LihongYang99/clam_factory_deployment/Batch1-111626.xlsx

For company inventory for 11/16/2026----batch 1
 | Material list | Mode | Quantity needed | Unit Price | Total Price | Purchase Method | Note
Sensors | DO sensor | RS485 Fluorescence Dissolved Oxygen Sensor (Seawater) (https://www.dfrobot.com/product-3009.html) | 1 | 164.68 | 164.68 | P-card
 | ORP sensor | Industrial-Grade RS485 Water Quality ORP Sensor (https://www.dfrobot.com/product-3102.html) | 1 | 192.28 | 192.28 | P-card
 | Conductivity Sensor | Conductivity K 10 Kit (https://atlas-scientific.com/kits/conductivity-k-10-kit/) | 1 | 242.99 | 242.99 | P-card
 | Ammonia sensor | Industrial RS485 Water Quality Ammonia Nitrogen & pH Sensor | 1 | 0 | 0 | N/A(available in lab)
 | Underwater camera | Barlus Underwater Cameras 304 Stainless Steel IP68 5MP 2592×1944 POE IP Camera 32Ft Cable Koi Pond Camera | 1 | 205 | 205 | Hokiemart(464879)
IoT equipment | Router | MikroTik C53UiG+5HPaxD2HPaxD, IPQ-6010, 2.4/5 GHz, W127080453 (IPQ-6010, 2.4/5 GHz, 802.11a/n/ac/ax, 1200 Mbit/s, USB 3.0 Type A) | 1 | 165.99 | 165.99 | Hokiemart(464879)
 | ESP32 S3 Dev module(Pack of 3) | Hosyond 3Pack ESP32-S3 Development Board N16R8 MCU with Dual-Mode Wi-Fi Bluetooth Type-C, Compatible with Arduino IoT ESP32-S3-WROOM-1 | 2 | 18.05 | 36.1 | Hokiemart(464879)
 | RS485 to TTL | Waveshare Rail-Mount TTL to RS485 Isolated Converter, Multi-Isolation Protection, Compatible with TTL/RS485 Standard | 4 | 18.99 | 75.96 | 4 from Hokiemart(464879) | Already have 2 available in Lab
 | micro SD card | SANDISK 1TB Extreme microSD Card + Adapter, Up to 190MB/s Read Speeds | 1 | 234.88 | 234.88 | 5 from Hokiemart(464879)
 | Jetson Orin Nano Developer Kit | NVIDIA Jetson Orin Nano Super Developer Kit | 1 | 399 | 399 | Hokiemart(464879)
 | Electrically Isolated EZO™ Carrier Board | Electrically Isolated EZO™ Carrier Board | 2 | 0 | 0 | N/A(available in lab)
Accessory | DuPont Thread kit | 120pcs 50cm Breadboard Jumper Wires Assorted Kit,10cm 15cm 20cm 30cm 40cm 100cm Optional Dupont Wire 19.7 inch Male to Female Male to Male Female to Female Multicolored Ribbon Cable | 1 | 13.99 | 13.99 | Hokiemart(464879)
 | HDMI cable | N/A | 1 | 0 | 0 | N/A(available in lab)
 | PSU for ESP 32 | 10-Pack USB Wall Charger, 5V 2A UL Certified Power Adapter Block Bulk White | 1 | 21.99 | 21.99 | Hokiemart(464879) | have 3 available in lab
 | ESP 32 power cable | Android Auto USB Cable [3ft, 2-Pack] 10Gbps, 3A Fast Charging | 3 | 9.49 | 28.47 | Hokiemart(464879)
 | terminal block for ESP | 10PCS Lever Wire Connectors, 2 in 8 Out Quick Wire Connectors, Electrical Lever Nuts Wire Connectors Push-in Conductor Terminal Block AWG 28-12 | 1 | 11.39 | 11.39
 | PSU for DO and OPR sensors(12V) | ALITOVE DC 12V 5A Power Supply Adapter Converter Transformer 60W AC 100-240V Input with 5.5x2.5mm DC Output Jack for 5050 3528 LED Strip Module LightALITOVE DC 12V 5A Power Supply Adapter Converter Transformer 60W AC 100-240V Input with 5.5x2.5mm DC Output Jack for 5050 3528 LED Strip Module Light | 2 | 12.99 | 25.98 | Hokiemart(464879)
 | Sodium Sulfite for DO calibration | Fisher Scientific Company LLC SOD SULFITE ANHYDROUS 500G | 1 | 41.29 | 41.29 | Hokiemart(464879)
 | ORP buffer, 200mV for calibraition | ORP buffer solution, 200 mV, 500 mL | 1 | 114 | 114 | Hokiemart(464879)
 | ORP buffer, 600mV for calibraition | ORP buffer solution, 200 mV, 500 mL | 1 | 114 | 114 | Hokiemart(464879)
 | Clips | Yarall 32 PCS Plastic Chip Clips for Food Packages, Curved Design Sealing Bag Clips for Food, Kitchen and Home, 2 Sizes(4.3inch x 20, 3.1inch x 12) | 1 | 7.59 | 7.59 | Hokiemart(464879)
 | Power strip | CCCEI Standing Desk Clamp Power Strip with 15 Outlets, Widely Spaced Desktop Edge Mount Surge Protector Outlet, Fast Charging USB-A and USB-C Ports, 15 FT Flat Plug, Black Fit 1.6 inch Table top. | 2 | 31.98 | 63.96 | Hokiemart(464879)
Other | Box carrier | BTSKY 2 Layer Stack & Carry Box, Plastic Multipurpose Portable Storage Container Box Handled Organizer Storage Box for Organizing Stationery, Sewing, Art Craft, Jewelry and Beauty Supplies(Red) | 1 | 22.79 | 22.79 | Hokiemart(464879)
 | Monitor for jetson orin nano | Spectra 28' | 1 | 79.99 | 79.99 | Hokiemart(464879)
 |  |  |  | Total: | 2262.32
 |  |  |  | SUM of this project: | 1662.37 | From NSF materail fees
 |  |  |  |  | 69.63 | Remaining material fees from NSF fund
Items haven't purchased | Turbidity sensor
 | COD sensor
