LihongYang99/clam_factory_deployment/(commit log)

2026-11-11 Add multi-sensor prediction dashboard and results API
2026-11-11 Compare probe temperatures and show a valid-reading average
2026-11-11 Display configured device IP addresses on the dashboard
2026-11-11 Reduce primary sidebar button labels to 16px
2026-11-11 Configure confirmed K10 probe and record Node 05 bench verification
2026-11-11 Guard Node 05 EC range and log sensor supply diagnostics
2026-11-14 ---- report---
    [Batch1-111626.xlsx]
